frankebenjamin1983-hash/weserbergland-umweltmonitor/pinout.txt

UmweltMonitor-Basismodul — Pinout (ESP32-D0WD NodeMCU, 30-Pin)
Stand 2026-06-25. Versorgung: 5 V an VIN. Am laufenden Board verifiziert.

ANALOG (ADC1 — auch bei aktivem WLAN nutzbar)
  GPIO36 (VP)   HW-390      Bodenfeuchte (AOUT)              3V3
  GPIO39 (VN)   HW-038      Wasserstand/Nässe (S)            3V3
  GPIO34        MAX9814     Schallpegel (OUT)                3V3
  GPIO35        MiCS-5524   Gas (AO; ggf. 10k/10k-Teiler)    5V
  GPIO32        GUVA-S12SD  UV (OUT)                         3V3
  GPIO33        Raindrop    Regen-Intensität (AO)            3V3

DIGITAL
  GPIO27        Raindrop    Regen ja/nein (DO)               3V3
  GPIO26        MiCS-5524   Heizer-Enable (EN, HIGH = an)    —

I2C-0  (GPIO21 = SDA / GPIO22 = SCL)   externe Pull-ups 4,7–10k an 3V3
  0x38   AHT20            Temp/Feuchte
  0x77   BMP280           Druck          << VERIFIZIERT 0x77 (NICHT 0x76!)
  0x29   TCS34725         Farbe/Helligkeit
  0x48   TMP102           Bodentemperatur
  0x50   MB85RC256V FRAM  32 KB Persistenz (seq, Ringpuffer) — A0/A1/A2 → GND

I2C-1  (GPIO18 = SDA / GPIO19 = SCL)
  0x29   TSL2591    Lux (HDR)       (eigener Bus wegen 0x29-Konflikt mit TCS34725)

SPI-HSPI  (ST7789 1.47" TFT Display)
  GPIO14        SCK
  GPIO13        MOSI
  GPIO25        CS    (GPIO15 gemieden — Strapping-Pin)
  GPIO16        DC    (GPIO2  gemieden — Strapping-Pin + Onboard-LED)
  GPIO4         RST
  GPIO17        BL    (Backlight PWM; prüfen ob direkt oder Transistor — GPIO-Limit 40 mA)

RESERVIERT / FREI LASSEN
  GPIO1 / GPIO3 (TX0 / RX0)  =  USB-Seriell (Panel-Live + Flashen) — nicht belegen.

Hinweise
  - ADC2-Pins sind bei aktivem WLAN gesperrt -> Analog nur über ADC1 (oben).
  - HW-038 / Raindrop korrodieren bei Dauerstrom -> nur zur Messung bestromen.
  - TMP102 + Bodenfeuchte ins Erdreich (gekabelt), TMP102 wasserdicht vergießen.
