frankebenjamin1983-hash/weserbergland-umweltmonitor/(commit log)

2026-06-26 Initial commit: UmweltMonitor-Basismodul (Firmware + Panel + Doku)
    Firmware (ESP32/Arduino): 5 I²C-Sensoren mit Presence-Gating, SIOF-Fix (globale Wire-Referenz),
    versionssicherer Watchdog, 1-min-JSON-Telemetrie, Echtzeit-Streams (Lärm/Licht), WLAN-Live-Stream
    (SSE + mDNS), echtes ISRG-Root-X1-CA, WLAN-Stabilität (Modem-Sleep aus + Auto-Reconnect).
    Panel (Web Serial + WLAN/SSE): Live-Werte, Ring-Gauges, CSV/JSON-Export, Reconnect-Watchdog.
    Doku: Testpläne, Stückliste, Pinout, Logik-Flussdiagramm, Abnahme, Sicherheitsarchitektur.
    [provisioning.ino, umweltmonitor_basis.ino]
2026-06-27 Stufe 1b+2: FRAM + ST7789 TFT aktiviert, Display-Layout + Farbvarianz
    - FRAM MB85RC256V (I2C 0x50): framLoadSeq/saveSeq aktiv, Magic 0xDEADBEEF,
    NVS nur als Fallback wenn kein FRAM (schont NVS-Schreibzyklen)
    - ST7789 1.47" TFT (SPI-HSPI): vollständig initialisiert, CS=GPIO25 DC=GPIO16
    (Strapping-Pins GPIO15/GPIO2 bewusst gemieden)
    - tftShow: Temp+Feuchte (size 3), Taupunkt+Druck+Lux+UV (size 2),
    FRAM/WLAN-Status+RSSI+Uptime; Farbvarianz dV als Lichtdynamik-Indikator
    - L:-Stream um dV-Feld erweitert: L:lux,uv,r,g,b,dV
    - Pinout + Stückliste: TFT-Pins auf 25/16 korrigiert (war 15/2)
    - Bibliotheken: Adafruit FRAM I2C 2.0.3, Adafruit ST7735/ST7789 1.11.0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
    [umweltmonitor_basis.ino]
2026-06-27 Repo aufgeräumt: alte Schemata/Prompts entfernt, Doku aktualisiert
    Entfernt (veraltet/überholt):
    - firmware/schema-*.png/svg (v8-v10, A7B3, aktuell-ohne-sgp40)
    - firmware/umweltmonitor-*schema.png/svg
    - firmware/belegungsplan*.svg, belegungsplan-und-entwurf.md, netlist-kicad.md
    - firmware/ABNAHME-WIFI-DROPTEST.md, ABNAHME-CHECKLISTE.md
    - prompts/ (alle 4 Dateien — veraltet, C3-Stand)
    - firmware/Bitmap-Bild (neu).bmp
    Aktualisiert:
    - firmware/anschlussliste.md: BMP280 0x77, FRAM 0x50, TFT SPI-Pins (CS=25 DC=16)
    - firmware/logik-flowchart.md: Reset-Grund, WLAN-Watchdog, FRAM, TFT, dV
2026-06-27 Lastenheft: TFT-Display und FRAM ins Hauptgehäuse aufgenommen
    2.6 Display: Frontfenster-Anforderungen (UV-beständig, regendicht, sonnentauglich),
    Footprint-Hinweis GMT147SPI.
    2.7 FRAM: Schutzanforderung (Elektronikfach, kein Kondensat).
    Abnahmekriterium Display ergänzt.
